MadsRudolph/esp32-surround-processor/enclosure/render/base-empty.webp

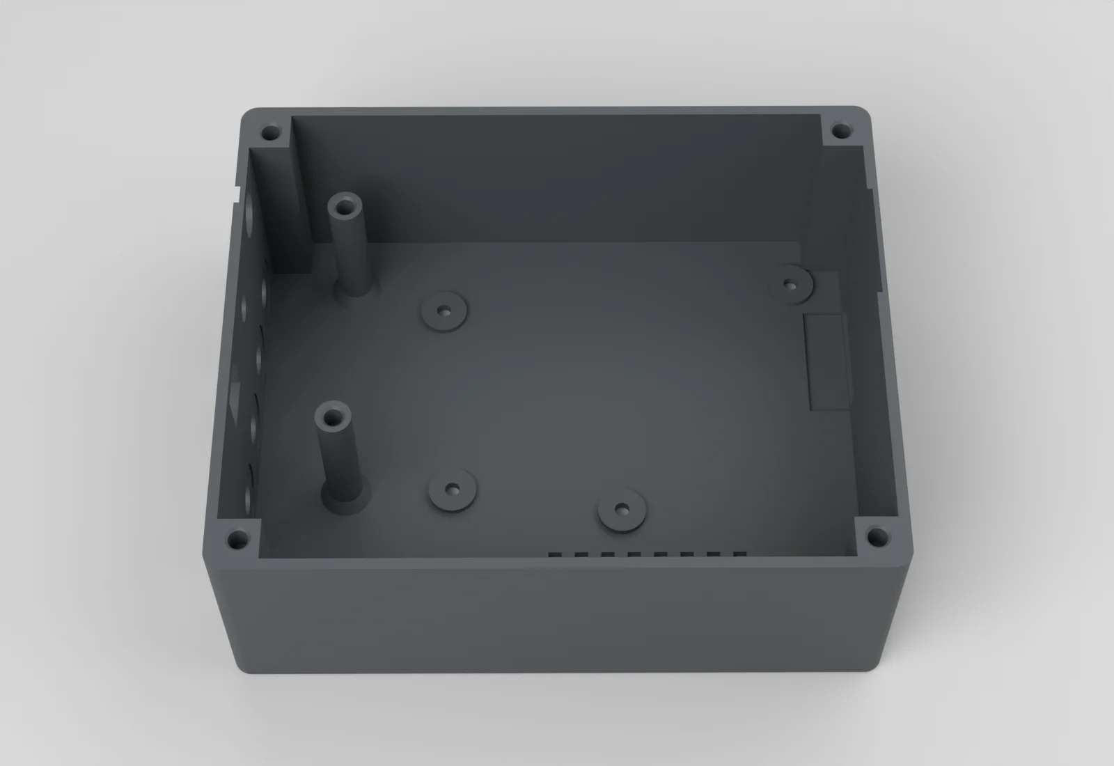
enclosure/render/base-empty.webp
