MadsRudolph/esp32-surround-processor/enclosure/render/button-cap.webp

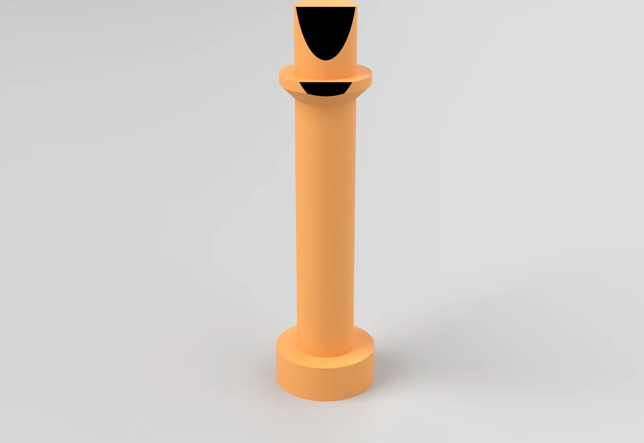
enclosure/render/button-cap.webp
