MadsRudolph/esp32-surround-processor/hardware/renders/bottom.webp

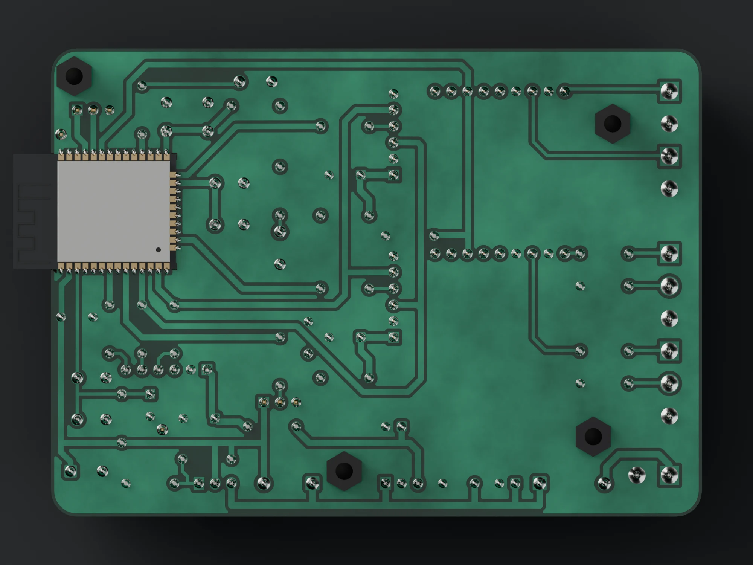
hardware/renders/bottom.webp
