MadsRudolph/esp32-surround-processor/hardware/renders/top.webp

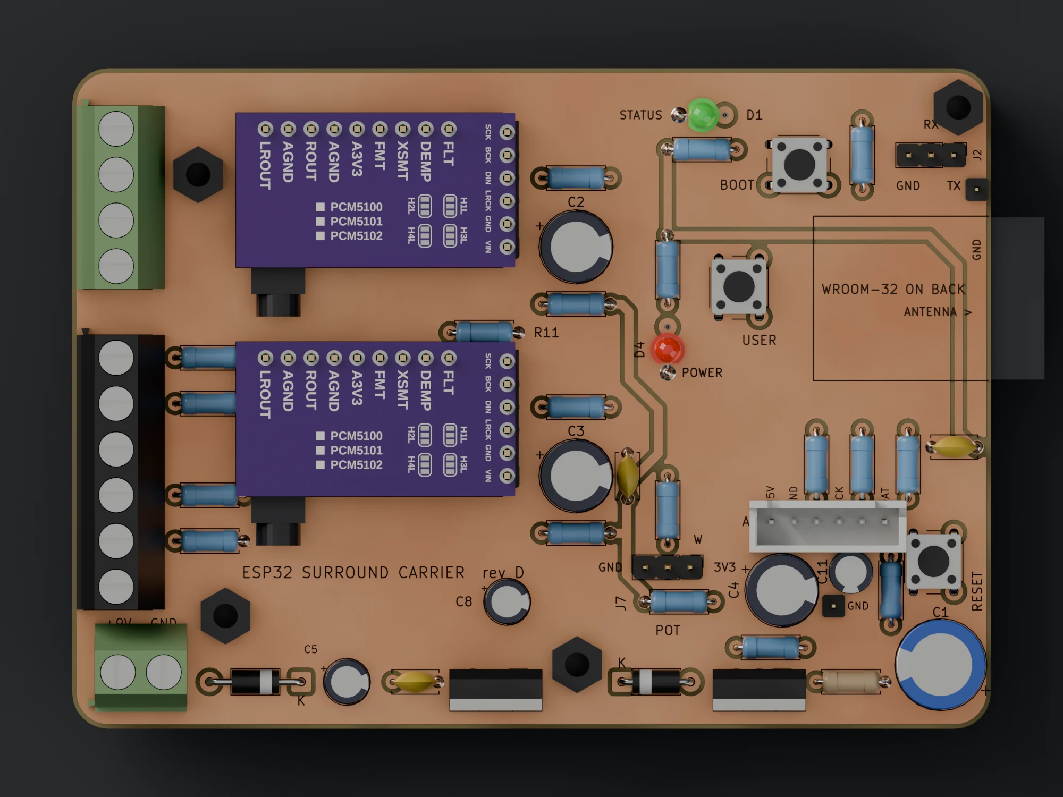
hardware/renders/top.webp
