MadsRudolph/esp32-surround-processor/enclosure/cad/Lid_Plate.step

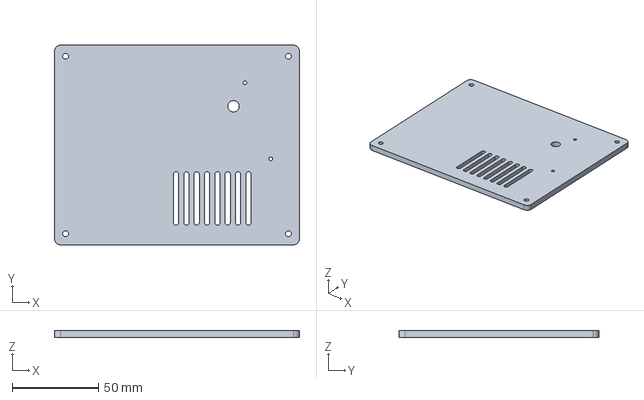
[picture p20: CAD file, 2026-11-13]
enclosure/cad/Lid_Plate.step
142.1 x 115.8 x 4.00 mm
