MadsRudolph/esp32-surround-processor/enclosure/lasercut/Lid_Plate_4mm_acrylic_R2000.dxf

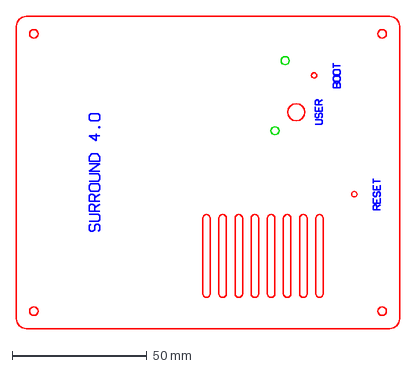
[picture p21: CAD file, 2026-11-14]
enclosure/lasercut/Lid_Plate_4mm_acrylic_R2000.dxf
142.3 x 116.0 mm
