MadsRudolph/esp32-surround-processor/enclosure/print/Pot_Fit_Test.stl

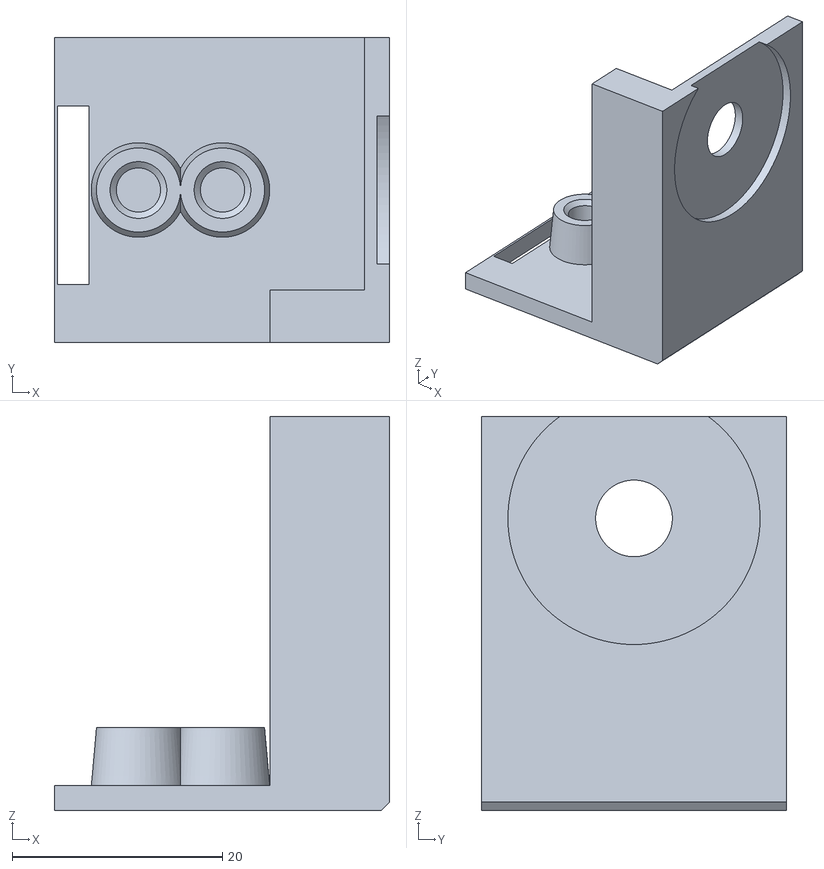
[picture p22: CAD file, 2026-11-13]
enclosure/print/Pot_Fit_Test.stl
31.9 x 29.0 x 37.5
