MadsRudolph/esp32-surround-processor/hardware/coupon/production/wroom_coupon_silk_top.dxf

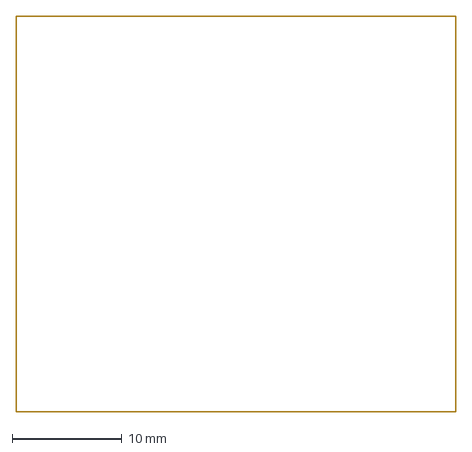
[picture p23: CAD file, 2026-11-04]
hardware/coupon/production/wroom_coupon_silk_top.dxf
40.0 x 36.0 mm
