MadsRudolph/esp32-surround-processor/hardware/production/surround_mask_bottom_mirrored.dxf

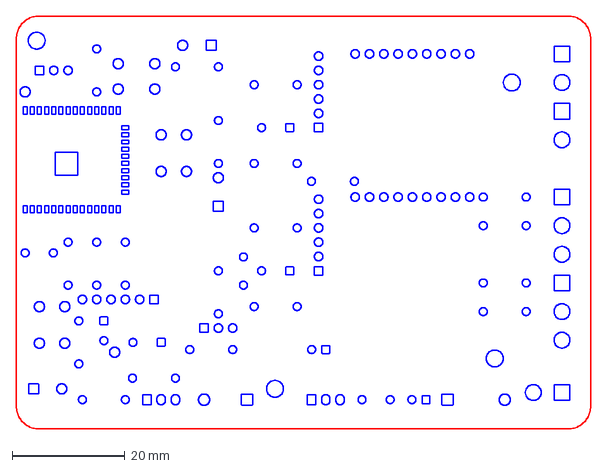
[picture p24: CAD file, 2026-11-12]
hardware/production/surround_mask_bottom_mirrored.dxf
101.9 x 73.2 mm
