MadsRudolph/esp32-surround-processor/hardware/renders/models/pcm5102_parts.step

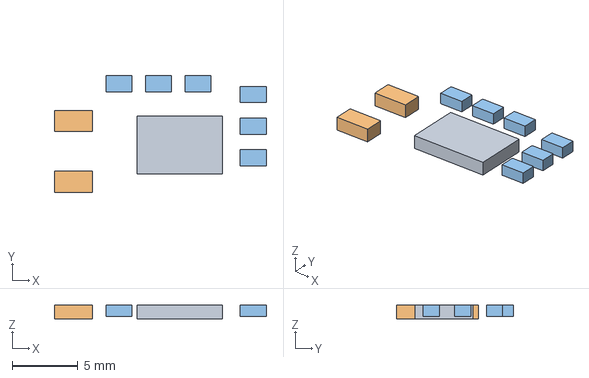
[picture p25: CAD file, 2026-11-12]
hardware/renders/models/pcm5102_parts.step
16.1 x 8.85 x 1.10 mm
