MadsRudolph/esp32-surround-processor/hardware/stencil_test/stencil_test.dxf

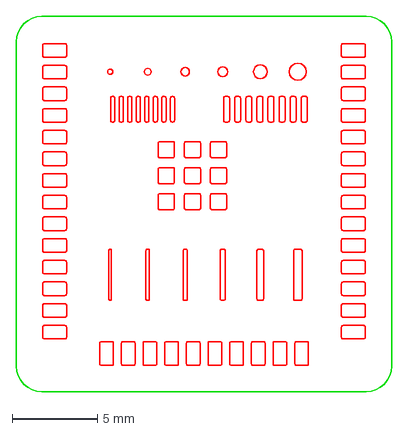
[picture p26: CAD file, 2026-11-13]
hardware/stencil_test/stencil_test.dxf
22.0 x 22.0 mm
