MadsRudolph/esp32-surround-processor/enclosure/cad/Knob.step

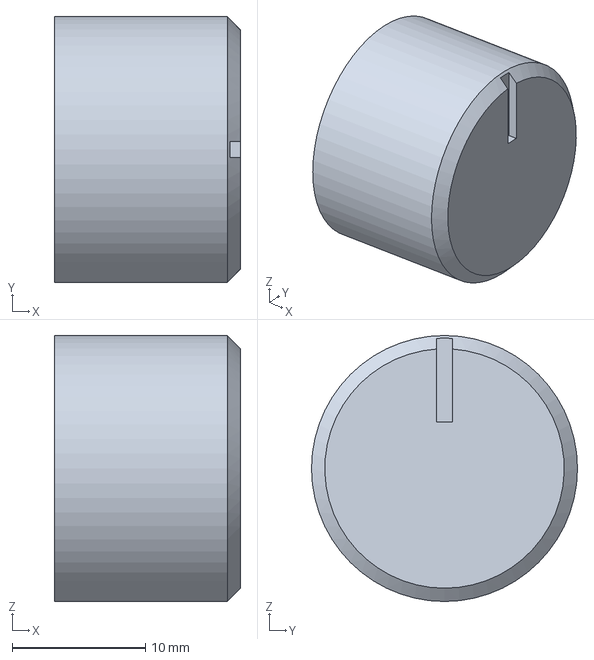
[picture p27: CAD file, 2026-11-13]
enclosure/cad/Knob.step
14.0 x 20.0 x 20.0 mm
