MadsRudolph/esp32-surround-processor/enclosure/lasercut/Lid_Plate_4mm_acrylic.dxf

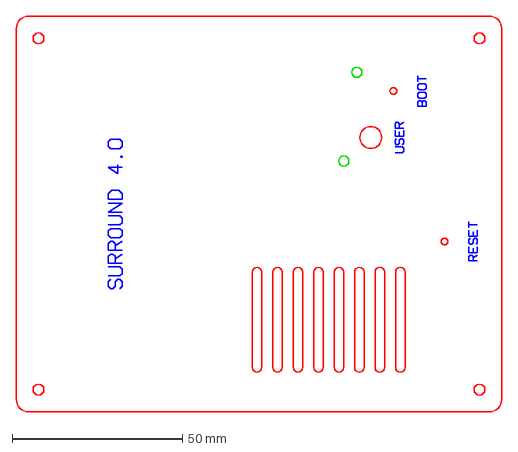
[picture p28: CAD file, 2026-11-14]
enclosure/lasercut/Lid_Plate_4mm_acrylic.dxf
142.3 x 116.0 mm
