MadsRudolph/esp32-surround-processor/hardware/renders/models/pcm5102_pins.step

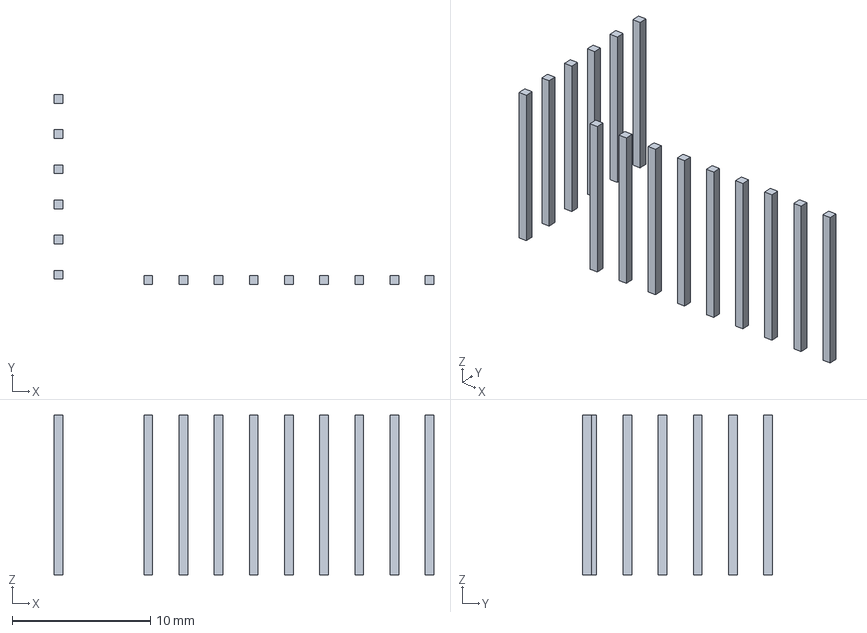
[picture p30: CAD file, 2026-11-12]
hardware/renders/models/pcm5102_pins.step
27.5 x 13.7 x 11.5 mm
