MadsRudolph/esp32-surround-processor/enclosure/cad/Pot_Cradle.step

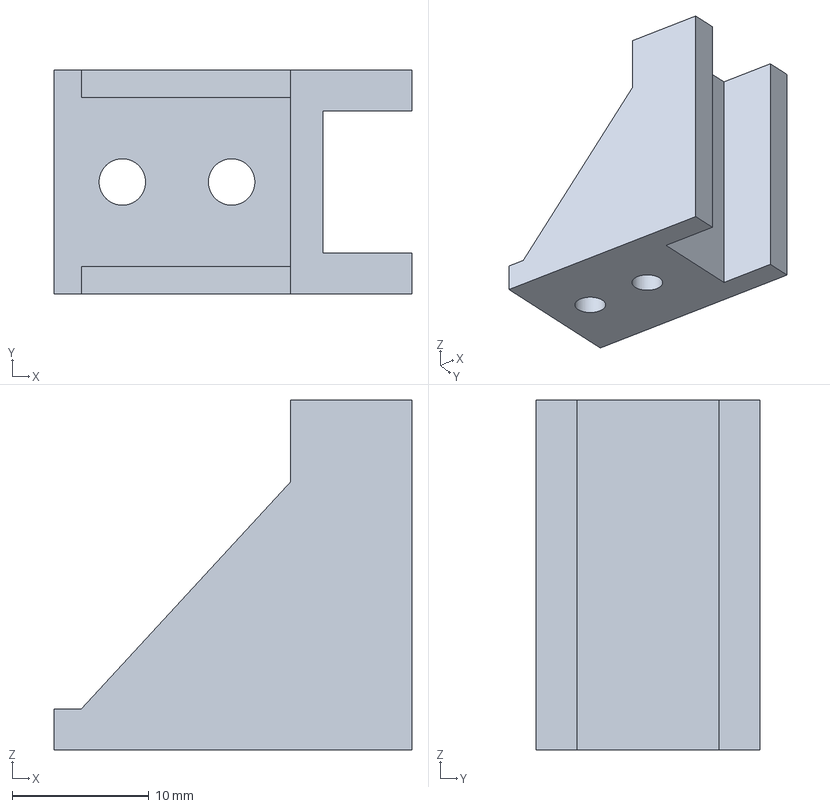
[picture p31: CAD file, 2026-11-13]
enclosure/cad/Pot_Cradle.step
26.2 x 16.4 x 25.6 mm
