MadsRudolph/esp32-surround-processor/hardware/production/surround_silk_top.dxf

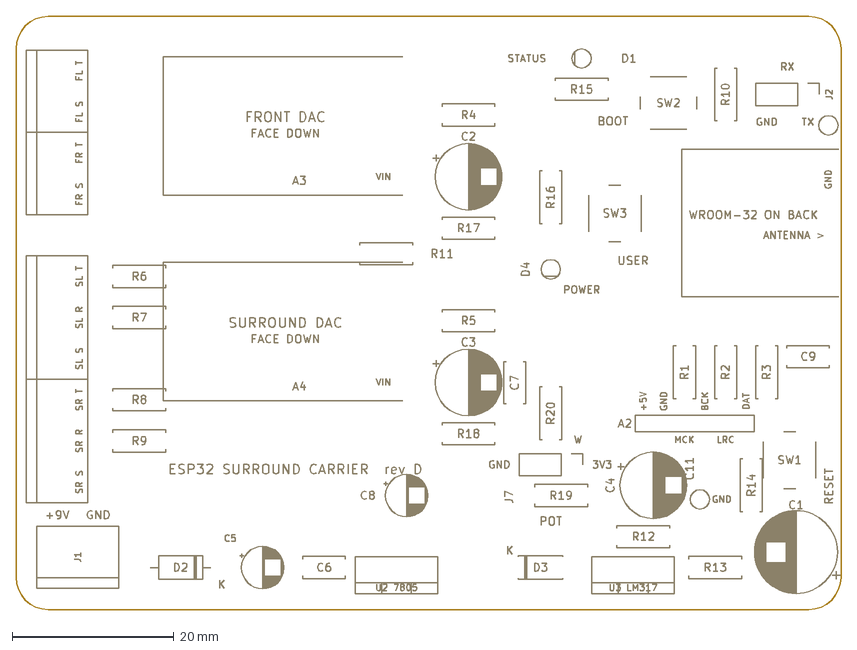
[picture p32: CAD file, 2026-11-10]
hardware/production/surround_silk_top.dxf
101.9 x 73.2 mm
