MadsRudolph/esp32-surround-processor/hardware/renders/models/pcm5102_pcb.step

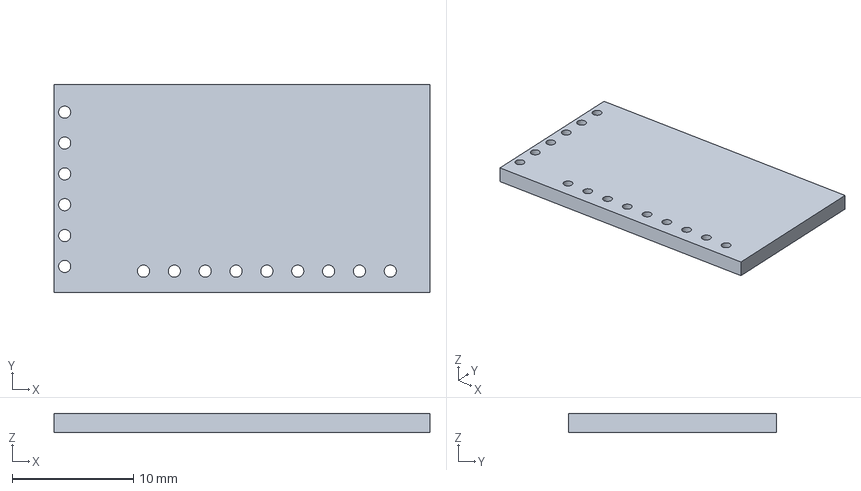
[picture p33: CAD file, 2026-11-12]
hardware/renders/models/pcm5102_pcb.step
31.0 x 17.1 x 1.60 mm
