MadsRudolph/esp32-surround-processor/enclosure/cad/User_Button.step

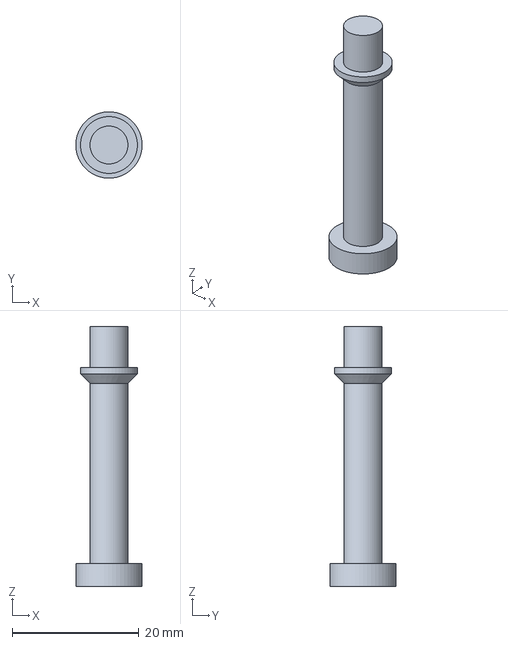
[picture p34: CAD file, 2026-11-13]
enclosure/cad/User_Button.step
10.5 x 10.5 x 41.1 mm
