MadsRudolph/esp32-surround-processor/hardware/renders/models/pcm5102_jack.step

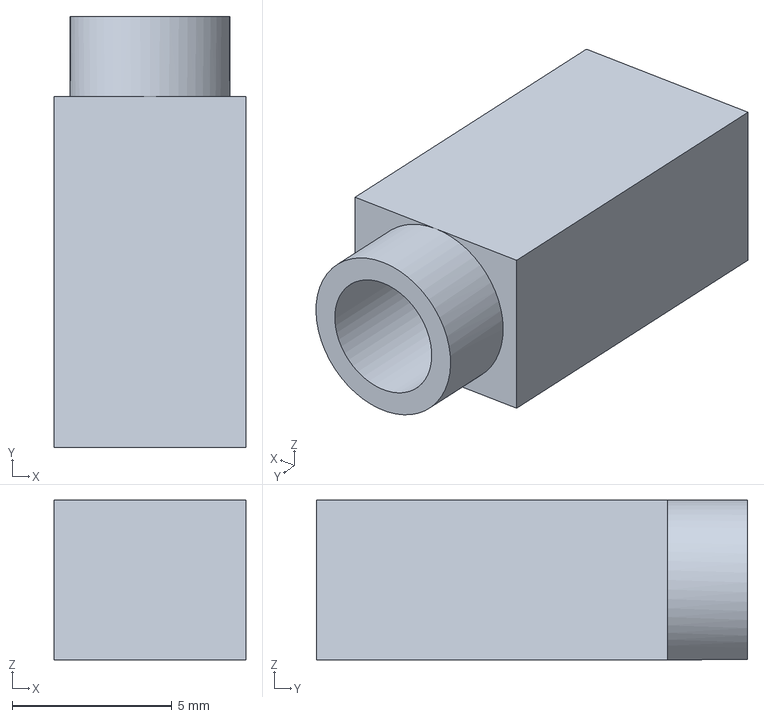
[picture p35: CAD file, 2026-11-12]
hardware/renders/models/pcm5102_jack.step
6.00 x 13.5 x 5.00 mm
