MadsRudolph/esp32-surround-processor/enclosure/cad/Base.step

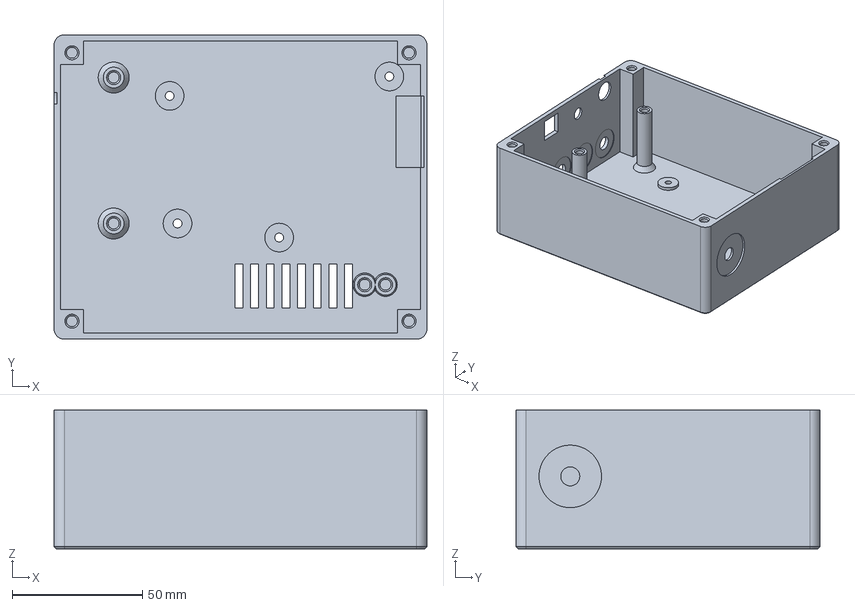
[picture p36: CAD file, 2026-11-13]
enclosure/cad/Base.step
143.1 x 116.8 x 53.2 mm
