MadsRudolph/esp32-surround-processor/hardware/renders/models/pcm5102_plastic.step

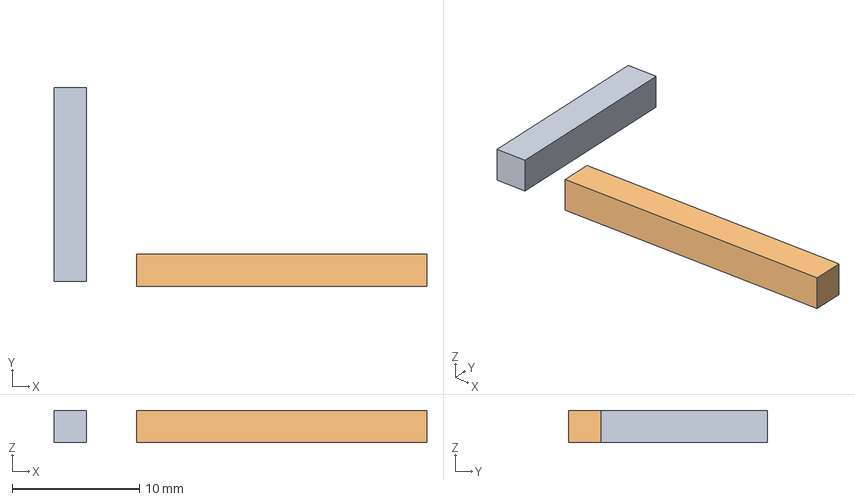
[picture p37: CAD file, 2026-11-12]
hardware/renders/models/pcm5102_plastic.step
29.4 x 15.6 x 2.54 mm
