MadsRudolph/esp32-surround-processor/enclosure/cad/surround_enclosure.step

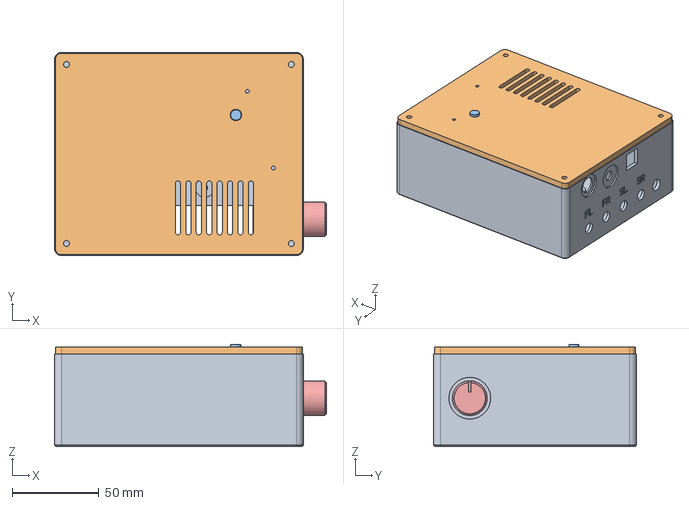
[picture p38: CAD file, 2026-11-13]
enclosure/cad/surround_enclosure.step
156.4 x 116.8 x 58.7 mm
