MadsRudolph/esp32-surround-processor/enclosure/cad/board.step

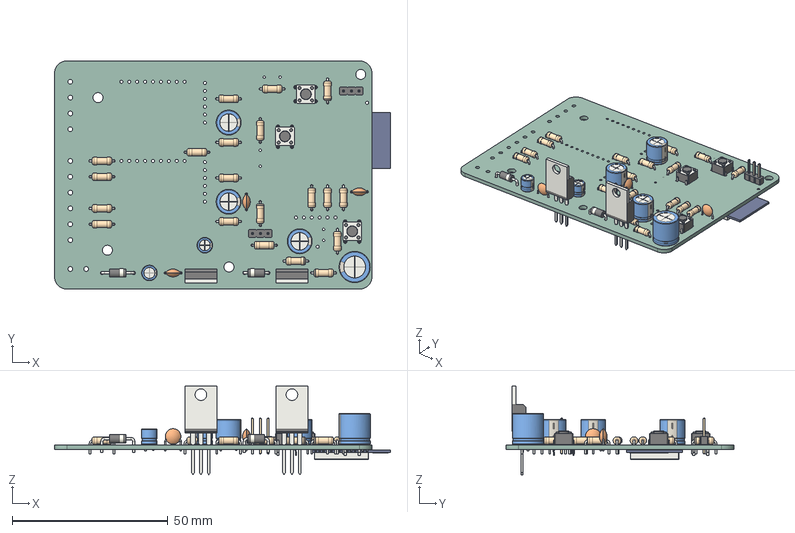
[picture p39: CAD file, 2026-11-12]
enclosure/cad/board.step
107.8 x 73.2 x 28.5 mm
PinHeader_1x03_P254mm_Vertical x 2
CP_Radial_D100mm_P500mm
CP_Radial_D80mm_P500mm x 3
R_Axial_DIN0207_L63mm_D25mm_P762mm_Horizontal x 20
TO-220-3_Vertical x 2
SW_PUSH_6mm x 3
CP_Radial_D50mm_P250mm x 2
D_DO-41_SOD81_P10.16mm_Horizontal
D_DO-41_SOD81_P7.62mm_Horizontal
C_Disc_D50mm_W25mm_P500mm x 3
ESP32-WROOM-32
surround_PCB
