MadsRudolph/esp32-surround-processor/(list of files, cad)

Other CAD files:
enclosure/cad/surround_enclosure.FCStd
enclosure/print/Base.stl
enclosure/print/Knob.stl
enclosure/print/Pot_Cradle.stl
enclosure/print/User_Button.stl
