MadsRudolph/esp32-surround-processor/tools/measure_guide.html

# Caliper measuring guide

Everything the enclosure still needs from you, with a drawing for each number. Type each answer into its box. Answers are saved in this browser as you type. Drawings are not to scale. Yellow badges on a drawing match the number on the card below it.

On a phone, swipe a drawing sideways to see all of it.

0 of 9 needed values filled inCopy answers

## 0How to measure

Outside jaws for diameters and thicknesses. Close them gently on the part, then read.

Depth rod for heights above the board: rod on the board, caliper body resting on the part top. Also for depth behind a panel.

Measure in mm. One decimal is enough. Pull the jaws away before you read if the display is hard to see, or lock it with the screw.

## AThe carrier board

Side view. Every arrow starts on the board top face (the face the parts stand on) and ends on the top of the part, except 1 and 7.

1

### Standoff length under the board

needed before printing

Pick one of the four black standoffs. Measure its length from the underside of the board to its bottom end, with the outside jaws. Look into the bottom end for a thread. Badge 1 on drawing A.

lengthmm

threaded M3 at the bottom

2

### Tallest part above the board

needed before printing

Rest the end of the depth rod on the board top, then slide the caliper body down until it touches the top of the tallest part. Read the value, and name the part. Badge 2 on drawing A.

height above top facemmwhich part

3

### Top of the DAC modules

needed before printing

Depth rod on the board top, caliper body resting on the highest point of a plugged-in DAC module (pins and solder included). Badge 3 on drawing A.

height above top facemm

4

### Top of the USER button

has a safe assumed value

Same method, on the top of the USER button plunger, not pressed. Badge 4 on drawing A.

height above top facemm

5

### Tops of the two LEDs

has a safe assumed value

Same method on the top of each LED dome. If the two differ, type the taller one. Badge 5 on drawing A.

height above top facemm

I will straighten them

6

### Screw terminal and blue capacitor

has a safe assumed value

Same method twice: once on the top of a screw terminal block, once on the top of the blue 470 uF can. Badges 6a and 6b on drawing A.

screw terminal heightmmblue capacitor heightmm

7

### Board thickness

has a safe assumed value

Close the outside jaws on the bare edge of the board, away from solder blobs. Badge 7 on drawing A.

thicknessmm

## BThe DIR9001 module

The green receiver board stacked above the carrier. Values 9, 10 and 14 are already settled.

8

### Standoff under the DIR9001 module

needed before printing

Measure straight up from the carrier top face to the underside of the module board (the standoff length is the same number). Solder joints under the module do not count. Badge 8 on drawing B.

gapmm

15

### Tallest part on the module

needed before printing

Depth rod on the module top face, caliper body on the highest part (look at the can, the optical socket and the toggle). Measure from the module top face, not from the carrier. Badge 15 on drawing B.

height above module top facemm

Top view of the socket edge, the long edge with the three sockets sticking out.

11

### Optical (TOSLINK) socket position

has a safe assumed value

11a: from the nearer short end of the module board to the middle of the socket opening (measure to the near side of the socket and add half its width). 11b: from the board edge to the front face of the socket. Badges 11a and 11b on drawing C.

11a end to centremm11b sticks outmm

12

### Toggle switch reach

has a safe assumed value

12a: from the board edge to the end of the threaded bushing. 12b: from the board edge to the lever tip, lever straight out. Badges 12a and 12b on drawing C.

12a bushingmm12b lever tipmm

13

### Coax RCA barrel

has a safe assumed value

From the board edge to the end of the metal barrel. Badge 13 on drawing C.

barrel sticks outmm

16

### Pigtail length

has a safe assumed value

Lay the cable straight and measure from the end of one plug to the end of the other. A ruler is fine. The layout needs 100 or more. Badge 16 on the small drawing.

plug to plugmm

## CPanel parts

The same three measurements for each jack. Part numbers are fine if a jack is not at hand. Swipe the drawing sideways if it is cut off on a phone.

A thread diameter, the hole the panel needs. B widest diameter of the nut or flange. C depth of the body and lugs behind the panel.

17a

### Gold RCA jack

needed before printing

Outside jaws on the threaded barrel (A) and on the nut or flange at its widest, corners of a hex nut included (B). Depth rod from the face that sits against the back of the panel to the rear end of the body and lugs (C). Letters A, B, C on drawing D.

A thread diametermmB flange / nut diametermmC depth behind panelmm

17b

### TRS jack

needed before printing

Outside jaws on the threaded barrel (A) and on the nut or flange at its widest, corners of a hex nut included (B). Depth rod from the face that sits against the back of the panel to the rear end of the body and lugs (C). Letters A, B, C on drawing D.

A thread diametermmB flange / nut diametermmC depth behind panelmm

plug size6.35 mm3.5 mm

17c

### DC jack

needed before printing

Outside jaws on the threaded barrel (A) and on the nut or flange at its widest, corners of a hex nut included (B). Depth rod from the face that sits against the back of the panel to the rear end of the body and lugs (C). Letters A, B, C on drawing D.

A thread diametermmB flange / nut diametermmC depth behind panelmm

The potentiometer, with its knob.

18

### Potentiometer

needed before printing

A thread (outside jaws on the bushing), B body diameter, C depth from the panel side of the body to its rear face (not the pins), D shaft diameter, E shaft length from the bushing end to the tip, F knob diameter (outside jaws across the knob). Letters A to F on drawing E.

A thread diametermmB body diametermmC body depthmmD shaft diametermmE shaft lengthmmF knob diametermm

## DTwo questions

19

### LM317 heatsink

no measuring

Will the LM317 regulator get a heatsink? If yes, give the size of the heatsink you plan to use.

heatsinkyesno

widthmmdepthmmtop above boardmm

?

### Jacks in hand

no measuring

Do you have the TRS jacks and the DC jack yet?

have themyesno

note (part numbers, where from)

## ✓Copy answers

One line per answered item. Unanswered items are left out. If the button cannot reach the clipboard, select the text below by hand.

Copy answersClear all
