MadsRudolph/esp32-surround-processor/hardware/stencil_test/preview.png

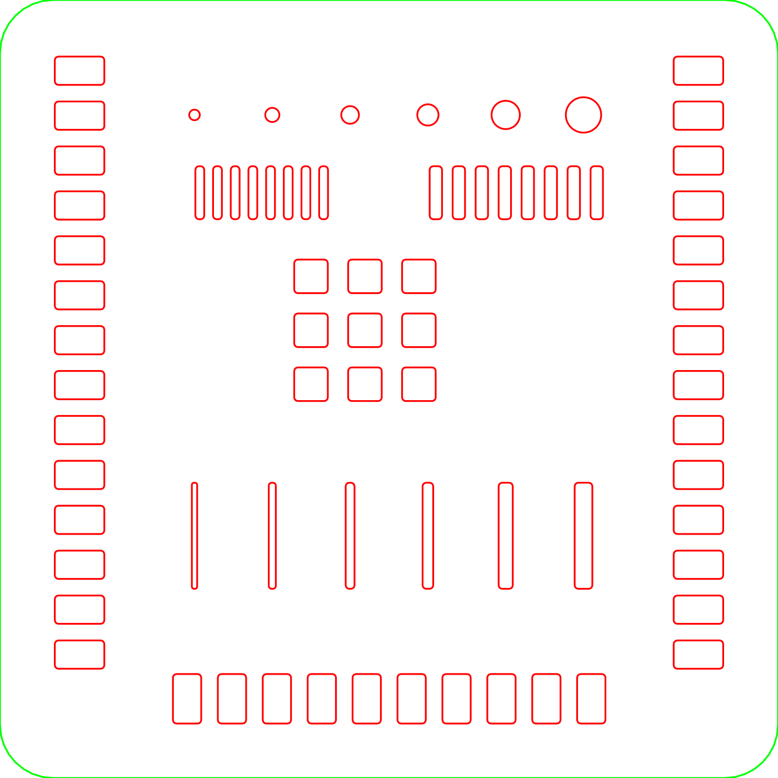
hardware/stencil_test/preview.png
