MadsRudolph/esp32-surround-processor/tools/debug_page.html

# Board debug

connecting Speaker wiring guide ← back to the bench

## Digital input

--Hz

waiting

## Volume pot (J7)

--dB

raw -- of 4095 · gain ×--

## Output

Mode: --

USER toggles mute. BOOT steps the mode: surround, stereo on all four, front only.

## Speaker test a test sound on one output only, the input is ignored

Front left Front right Surround left Surround right All four Stop test

Sound: Chime Sine sweep, 100 Hz to 10 kHz

The test follows the volume pot and is silent while the board is muted.

Board: Mute / unmute Mode: Surround Stereo on all four Front only

Data line drive (click hunting): Weakest Weak Normal Strong

## Input level, peak per second (before the volume pot)

L

R

S

dBFS

S (green) is what goes to the rear speakers. On stereo sound it is the matrix signal, 0.5 × (L − R) after its filters and delay. On Dolby Digital it is the louder of the two real rear channels, and L and R are the decoded fronts. Last two minutes. White marks on the bars hold the highest peak of the last 10 s. 0 dBFS is digital full scale.

## Audio path health

Read timeouts (no clock from the DIR9001) | --
Write errors (DAC side) | --
Since this page opened | --
Dolby Digital frames decoded | --
Dolby errors / dropped / underruns | --
Dolby decode time, average / worst (32 ms budget) | --

## Board

Firmware | --
Built | --
Running from | --
Uptime | --
Free memory | --
Address | --

Bench setup: the AD3 in place of the TV

Not yet proven on this board: that the DIR9001 locks to the AD3's signal. The generator itself passes its self-test.

### Move and power

1. Put the board on the bench and power it from the bench supply: 9 V, current limit 0.5 A. On the DIR9001 module (the green board stacked on top, marked "LHY AUDIO DIR9001-I2S"), flip the toggle switch to the coax input.

### Make the cable

2. Take a spare RCA cable and cut one end off. Inside are a centre conductor and a shield. The RCA plug at the other end goes into the red RCA jack on the DIR9001 module.

### Three resistors, wired at the cut end

3. All three are from home stock. Wire them like this:
  This turns the AD3's 3.3 V into about 0.4 to 0.8 V, the normal level for coax S/PDIF.

### Other AD3 connections

  - DIO 0 stays on the board's serial pin J2 TX. This is optional, it is for the console.
  - Scope probes set to 10x. Probe 1 on BCK at the front DAC socket. Probe 2 on that DAC's data pin. Ground clips on the DAC's ground.

The probe positions change from test to test. These are the ones for the first test.

### Start the generator

5. Run these from the repo folder:

python3 tools/spdif_gen.py selftest
python3 tools/spdif_gen.py run 1017 1526 -12
  selftest needs no wiring. It checks the AD3 pattern by reading it back. run 1017 1526 -12 plays 1017 Hz on the left, 1526 Hz on the right, at -12 dBFS. Ctrl-C stops it.
  A negative right frequency, for example run 1017 -1017 -12, sends the same tone inverted on the right. That is pure surround for the matrix decoder.
  Only one program can use the AD3 at a time. Before starting the generator, press "Release AD3" on the bench page (http://127.0.0.1:8791/). Do not run scope measurements there while the generator runs.

### What you should see on this page

  - Digital input: "LOCKED, 48 kHz PCM" with about 48,828 Hz. The AD3's rate is 1.7 % above 48,000, which is fine.
  - The L and R meters at about -12 dB.
  - With the two different tones, the S meter is active.

If it stays on "NO INPUT SIGNAL", check that the toggle is on coax, that the centre and shield are not swapped, and that the generator is running.

### What this setup can and cannot test

7. Can:
  - Clicks and data-line disturbance, with the scope.
  - Long soak tests.
  - Distortion and noise of each output.
  - The stereo matrix decoder.

Cannot:

  - Dolby Digital. One Dolby frame needs 1,536 audio frames and the AD3 pattern memory holds 256. That stays tested with the TV and with tools/dolby_test.sh on the PC.
