MadsRudolph/esp32-surround-processor/hardware/surround.kicad_pcb

## KiCad design hardware/surround.kicad_pcb (2026-11-10)

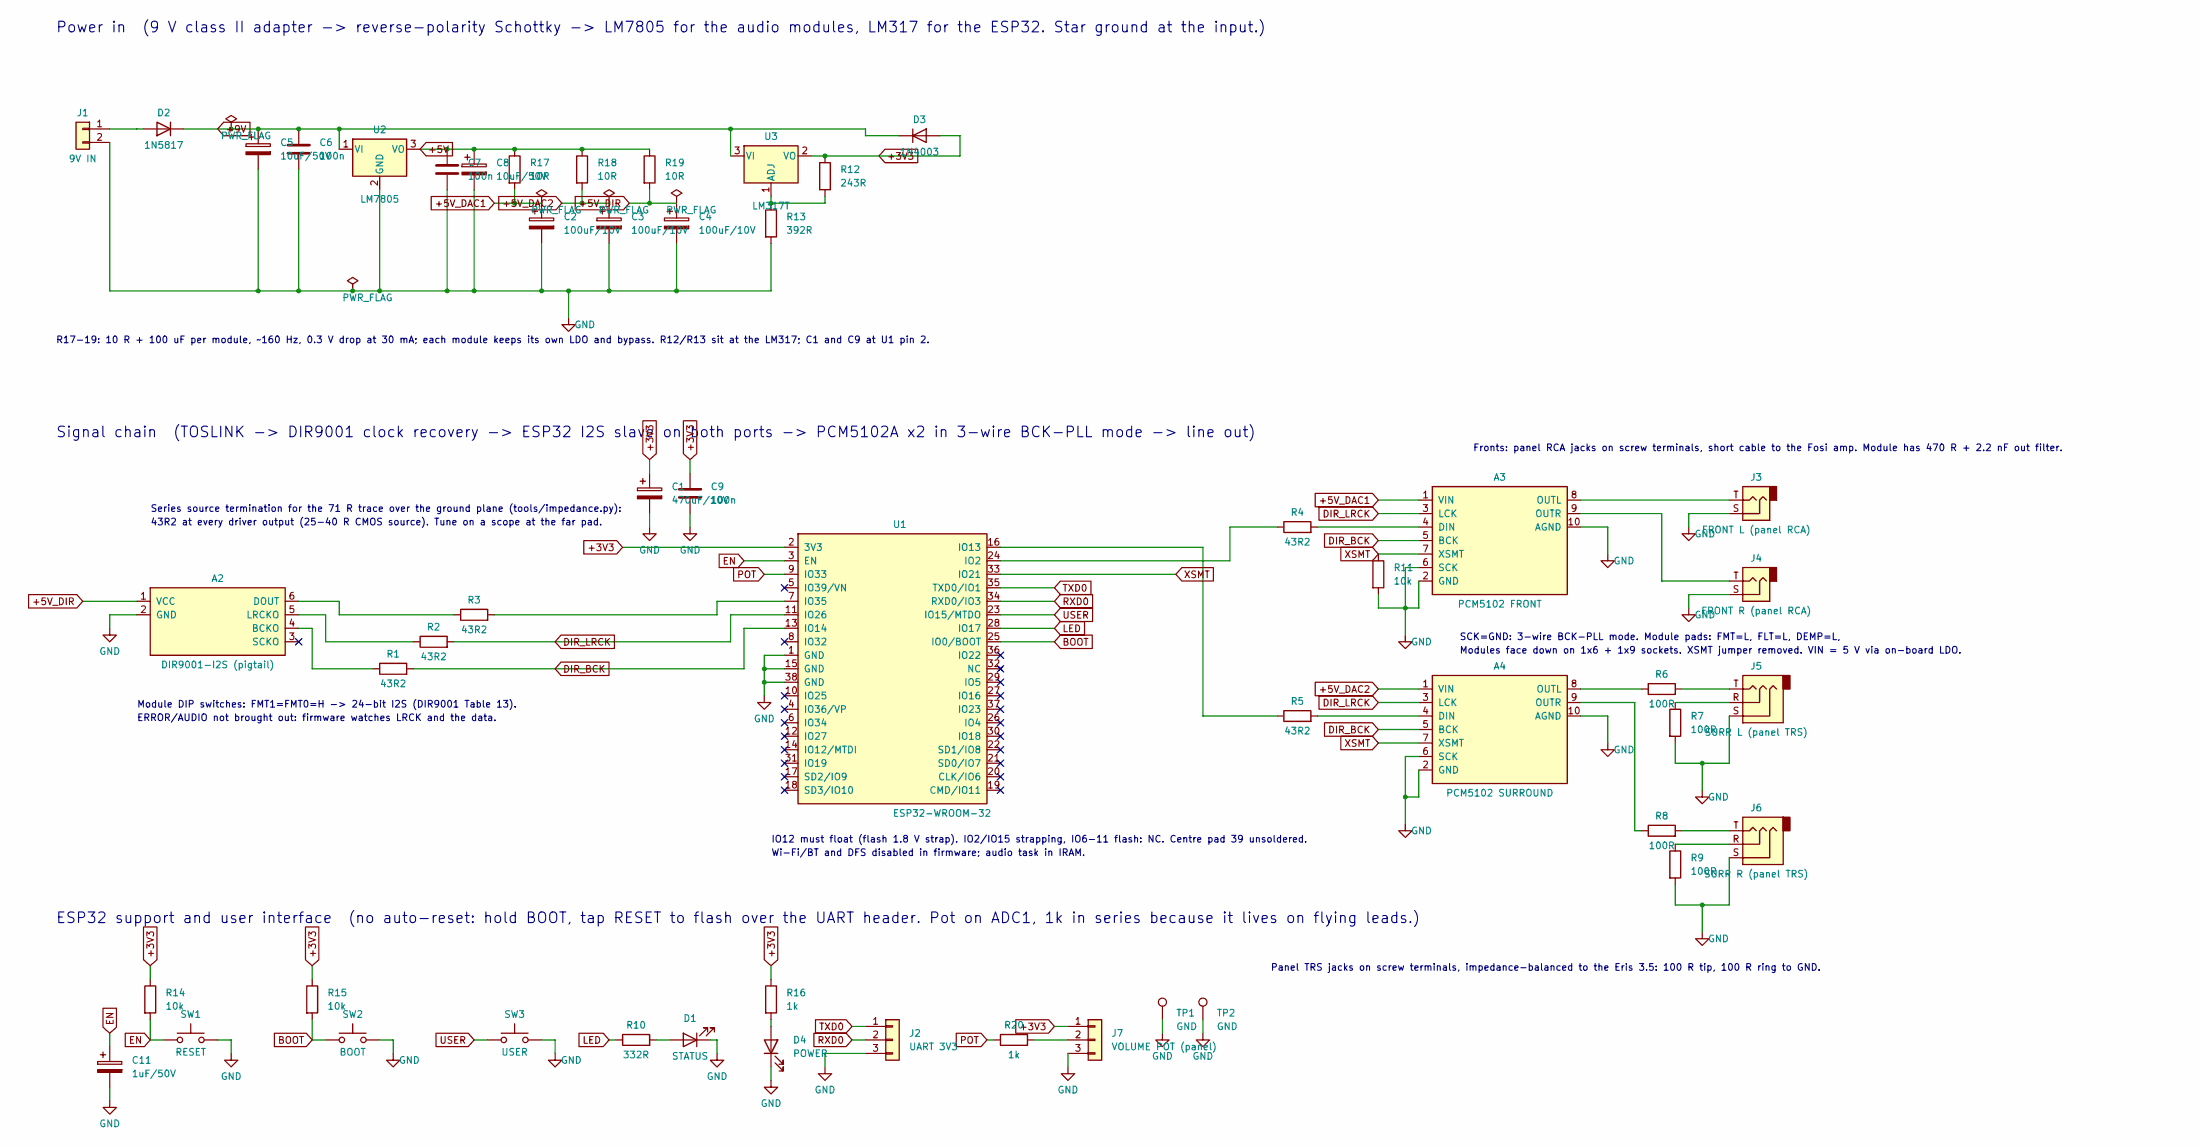
[picture p42: schematic surround.kicad_sch, ESP32 4.0 surround processor - carrier board]

Parts:
A2: DIR9001-I2S (pigtail); DIR9001_Pigtail_1x6
A3: PCM5102 FRONT; PCM5102_Module_FaceDown
A4: PCM5102 SURROUND; PCM5102_Module_FaceDown
C1: 470uF/10V; CP_Radial_D10.0mm_P5.00mm
C2, C3, C4: 100uF/10V; CP_Radial_D8.0mm_P5.00mm
C5, C8: 10uF/50V; CP_Radial_D5.0mm_P2.50mm
C6, C7, C9: 100n; C_Disc_D5.0mm_W2.5mm_P5.00mm
C11: 1uF/50V; CP_Radial_D5.0mm_P3.50mm_FormedLeads
D1: STATUS; LED_D3.0mm_P5.08mm_LaserPads
D2: 1N5817; D_DO-41_SOD81_P10.16mm_Horizontal
D3: 1N4003; D_DO-41_SOD81_P7.62mm_Horizontal
D4: POWER; LED_D3.0mm_P5.08mm_LaserPads
J1: 9V IN; TerminalBlock_2P_P5.08mm
J2: UART 3V3; PinHeader_1x03_P2.54mm_Vertical
J3: FRONT L (panel RCA); TerminalBlock_TS_P5.08mm
J4: FRONT R (panel RCA); TerminalBlock_TS_P5.08mm
J5: SURR L (panel TRS); TerminalBlock_TRS_P5.08mm
J6: SURR R (panel TRS); TerminalBlock_TRS_P5.08mm
J7: VOLUME POT (panel); PinHeader_1x03_P2.54mm_Vertical
R1, R2, R3, R4, R5: 43R2; R_Axial_DIN0207_L6.3mm_D2.5mm_P7.62mm_Horizontal
R6, R7, R8, R9: 100R; R_Axial_DIN0207_L6.3mm_D2.5mm_P7.62mm_Horizontal
R10: 332R; R_Axial_DIN0207_L6.3mm_D2.5mm_P7.62mm_Horizontal
R11, R14, R15: 10k; R_Axial_DIN0207_L6.3mm_D2.5mm_P7.62mm_Horizontal
R12: 243R; R_Axial_DIN0207_L6.3mm_D2.5mm_P7.62mm_Horizontal
R13: 392R; R_Axial_DIN0207_L6.3mm_D2.5mm_P7.62mm_Horizontal
R16, R20: 1k; R_Axial_DIN0207_L6.3mm_D2.5mm_P7.62mm_Horizontal
R17, R18, R19: 10R; R_Axial_DIN0207_L6.3mm_D2.5mm_P7.62mm_Horizontal
SW1: RESET; SW_PUSH_6mm
SW2: BOOT; SW_PUSH_6mm
SW3: USER; SW_PUSH_6mm
TP1, TP2: GND; TestPoint_THTPad_D2.0mm_Drill1.0mm
U1: ESP32-WROOM-32; ESP32-WROOM-32_NoVias
U2: LM7805; TO-220-3_Vertical_LaserPads
U3: LM317T; TO-220-3_Vertical_LaserPads

Connections:
+3V3: C1.1, C9.1, D3.2 (A), J7.1, R12.1, R14.1, R15.1, R16.1, U1.2 (3V3), U3.2 (VO)
+5V: C7.1, C8.1, R17.1, R18.1, R19.1, U2.3 (VO)
BOOT: R15.2, SW2.1, U1.25 (IO0/BOOT)
DIR_BCK: A3.5 (BCK), A4.5 (BCK), R1.2, U1.13 (IO14)
DIR_LRCK: A3.3 (LCK), A4.3 (LCK), R2.2, U1.11 (IO26)
EN: C11.1, R14.2, SW1.1, U1.3 (EN)
LED: R10.1, U1.28 (IO17)
unnamed: A2.4 (BCKO), R1.1
unnamed: A2.6 (DOUT), R3.1
unnamed: A2.5 (LRCKO), R2.1
unnamed: A3.4 (DIN), R4.2
unnamed: A3.8 (OUTL), J3.T
unnamed: A3.9 (OUTR), J4.T
unnamed: A4.4 (DIN), R5.2
unnamed: A4.8 (OUTL), R6.1
unnamed: A4.9 (OUTR), R8.1
unnamed: D1.2 (A), R10.2
unnamed: D2.2 (A), J1.1
unnamed: D4.2 (A), R16.2
unnamed: J5.R, R7.1
unnamed: J5.T, R6.2
unnamed: J6.R, R9.1
unnamed: J6.T, R8.2
unnamed: J7.2, R20.2
unnamed: R4.1, U1.24 (IO2)
unnamed: R5.1, U1.16 (IO13)
unnamed: R3.2, U1.7 (IO35)
unnamed: R12.2, R13.1, U3.1 (ADJ)
POT: R20.1, U1.9 (IO33)
RXD0: J2.2, U1.34 (RXD0/IO3)
TXD0: J2.1, U1.35 (TXD0/IO1)
USER: SW3.1, U1.23 (IO15/MTDO)
XSMT: A3.7 (XSMT), A4.7 (XSMT), R11.1, U1.33 (IO21)

Notes on the sheet:
Power in (9 V class II adapter -> reverse-polarity Schottky -> LM7805 for the audio modules, LM317 for the ESP32. Star ground at the input.)
R17-19: 10 R + 100 uF per module, ~160 Hz, 0.3 V drop at 30 mA; each module keeps its own LDO and bypass. R12/R13 sit at the LM317; C1 and C9 at U1 pin 2.
Signal chain (TOSLINK -> DIR9001 clock recovery -> ESP32 I2S slave on both ports -> PCM5102A x2 in 3-wire BCK-PLL mode -> line out)
Series source termination for the 71 R trace over the ground plane (tools/impedance.py):
43R2 at every driver output (25-40 R CMOS source). Tune on a scope at the far pad.
Module DIP switches: FMT1=FMT0=H -> 24-bit I2S (DIR9001 Table 13).
ERROR/AUDIO not brought out: firmware watches LRCK and the data.
IO12 must float (flash 1.8 V strap). IO2/IO15 strapping, IO6-11 flash: NC. Centre pad 39 unsoldered.
Wi-Fi/BT and DFS disabled in firmware; audio task in IRAM.
SCK=GND: 3-wire BCK-PLL mode. Module pads: FMT=L, FLT=L, DEMP=L,
Modules face down on 1x6 + 1x9 sockets. XSMT jumper removed. VIN = 5 V via on-board LDO.
Fronts: panel RCA jacks on screw terminals, short cable to the Fosi amp. Module has 470 R + 2.2 nF out filter.
Panel TRS jacks on screw terminals, impedance-balanced to the Eris 3.5: 100 R tip, 100 R ring to GND.
ESP32 support and user interface (no auto-reset: hold BOOT, tap RESET to flash over the UART header. Pot on ADC1, 1k in series because it lives on flying leads.)

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
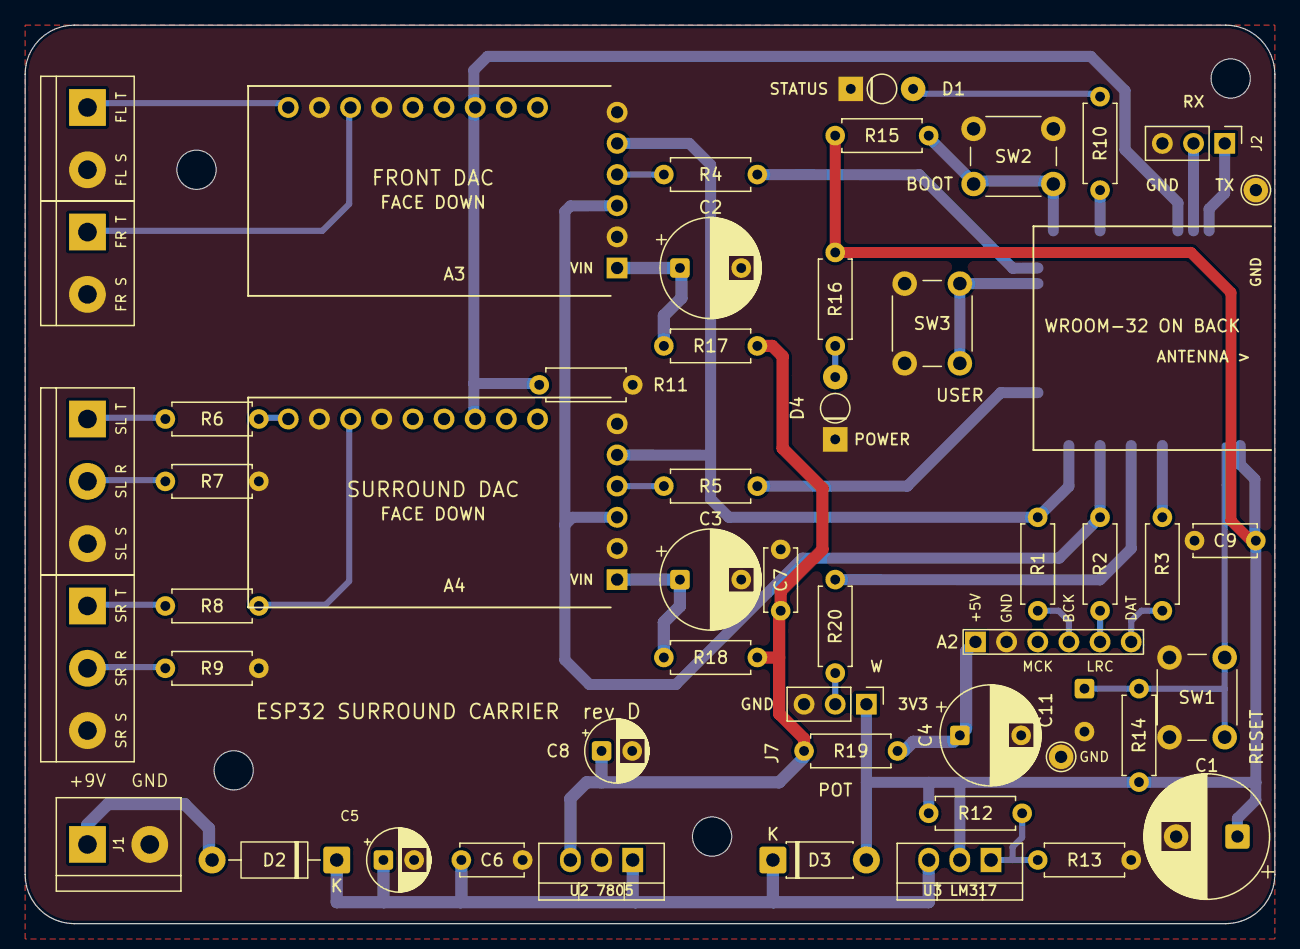
[picture p43: board surround.kicad_pcb from above]

Board: 2 copper layers, 101.9 x 73.2 mm, 56 parts (1 on the bottom side), 38 nets.

Other parts of the board:
H1, H2, H3, H4: M3; MountingHole_3.2mm_M3
