MadsRudolph/esp32-surround-processor/(commit log)

2026-09-10 Initial design: review document and KiCad carrier-board schematic
    Engineering review of the ESP32 4.0 surround processor (clocking, pinout,
    wiring, power, grounding, firmware and buffer sizing), and a KiCad 10
    project for the carrier board that hosts the ESP32-DevKitC, DIR9001 and
    two GY-PCM5102 modules. The schematic is generated by
    tools/surround_layout.py from project symbols built by
    tools/make_symbols.py; ERC is clean and the exported netlist has been
    checked against the review's topology.
    [surround.kicad_sch]
2026-09-10 Footprints, board bootstrap and hand placement for the carrier PCB
    Project footprint library (module carriers on pin sockets, screw terminals
    for the panel jacks, encoder header, mill-safe LED pads), every pad gap
    audited against the 0.8 mm end mill; sockets get intra-footprint DRC
    exceptions in surround.kicad_dru. The I2S GPIO map is re-ordered so the
    DIR9001-sourced and DAC-bound signals form two contiguous groups on the
    DevKitC socket row, which the floor oracle certifies routes single-sided
    with the GND pour and no wire bridge. Board is 140 x 110 mm, placed from
    tools/surround.placement.json.
    [surround.kicad_pcb, surround.kicad_sch]
2026-09-11 Route the carrier board single-sided, with the fast nets on milled copper
    The I2S clocks and data and the DAC outputs are pinned to the bottom layer for
    the whole route, so every wire link that comes back lands on a DC rail, ground,
    or a slow control line; tools/wire_links.py fails the build otherwise. 47 of 48
    nets route, with no vias and no clearance violations.
    Track widths follow from the process rather than from a default. The 0.8 mm end
    mill limits the copper GAP, not the track, so signal tracks are 0.8 mm and power
    1.5 mm: at 0.8 mm the pitch is 1.65 mm and the corridor beside the DAC headers
    takes two tracks instead of one, which is what made the board routable.
    With the ground pou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
    [surround.kicad_pcb, surround.kicad_sch, surround.routed.kicad_pcb]
2026-11-04 Redesign the carrier board for the 0.8 mm ball mill
    The board moves to the cnc-fine rules (0.50/0.50) and is now 133 x 70 mm and
    single-sided, with no vias. The ESP32-DevKitC carrier is replaced by a bare
    WROOM-32 soldered on the milled side, the barrel jack by a 9 V screw terminal,
    and the encoder by a pot and three buttons. The DAC modules get a worst-case
    32 x 24 mm reservation until they have been measured.
    Copper is now written by tools/surround_board.py instead of FreeRouting, and the
    build stops if a rule breaks: every segment is horizontal, vertical or 45 degrees,
    no run turns by more than 45 degrees, and every track leaving the ESP32 is 0.9 mm,
    the width of its pads. Parts are plac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
    [surround.kicad_pcb, surround.kicad_sch, surround.routed.kicad_pcb, surround_silk_top.dxf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]
2026-11-09 Compact 103 x 69 mm layout with the antenna off the edge (work in progress)
    The WROOM-32 now sits at the east edge with its antenna pointing off the board,
    so the keep-out starts at the edge. Its castellation rows face north and south,
    and the GPIOs are reassigned so each signal leaves the pin facing its copper
    (pin map in hardware/BUILD-NOTES.md).
    DACs: measured PCM5102A modules mount face down on a 1x6 and a 1x9 socket, so
    XSMT and the outputs are socketed. DIR9001: the LHY AUDIO DIR9001-I2S board
    sits off the carrier; its pigtail lands on six labelled pads. ERROR and AUDIO
    are dropped; firmware watches LRCK and the data instead.
    Routing is done by tools/octoroute.py, a single-layer octi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
    [surround.kicad_pcb, surround.kicad_sch]
2026-11-09 Double-sided board: ground plane on top, no vias, no wire links
    The carrier is re-laid-out from scratch for double-sided stock, 101.9 x 71.1 mm,
    both faces milled with the 0.8 mm ball mill. The holes are bare, so the faces
    meet only at 19 leads soldered on both sides: resistors, disc caps, LEDs, the
    7805 and two wire loops that double as scope grounds.
    The bottom carries every clock, data and audio track and the WROOM-32, antenna
    off the east edge. The top is a ground plane with a ring round each non-ground
    hole, plus +5V to the DAC feed resistors and +3V3 to the BOOT pull-up and the
    power LED. The two DAC blocks are identical, 25.4 mm apart; BCK runs dead
    straight under the parts that stra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
    [surround.kicad_pcb, surround.kicad_sch, surround_silk_top.dxf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]
2026-11-10 Hand-finish the board: rounded outline, chamfered corners, mask and silk Gerbers
    The outline gets rounded corners and grows to 101.9 x 73.3 mm. Several track
    corners are re-drawn with 45 degree chamfers, the +9V rail and a few short nets
    are re-laid, and C9 is turned so its ground lead sits west of the +3V3 lead.
    The east edge is unchanged, so the antenna still hangs off it.
    The export now also writes F.Silkscreen, F.Mask and B.Mask, which SRM-CAM
    turns into the laser files for the silkscreen and the solder mask.
    DRC has no copper errors and nothing unconnected, and check_board.py still
    passes on the same 19 leads. The README says how to re-export after a hand
    change, since tools/build.sh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
    [surround-B_Cu.gbl, surround-B_Mask.gbs, surround-Edge_Cuts.gm1, surround-F_Cu.gtl, surround-F_Mask.gts, surround-F_Silkscreen.gto, surround-job.gbrjob, surround.drl]
2026-11-12 Firmware and bench tools: Dolby Digital 5.1 and stereo matrix on four speakers
    The board is cut, soldered and brought up, and it plays.
    Firmware (ESP-IDF v5.5, firmware/):
    - surround: decodes Dolby Digital (AC-3) from the TV's optical bitstream with
    liba52 and sends real rear left and right to the surround DAC; stereo PCM goes
    through a matrix (0.5 x (L - R), 100 Hz to 7 kHz, 20 ms delay). Centre and LFE
    are folded into the fronts. Volume pot, mute, modes, speaker test (chime or
    sine sweep), all readable and settable over HTTP.
    - passthrough and boardtest: the two bring-up firmwares.
    - components/netota: Wi-Fi, over-the-air update with rollback, /status, /set.
    - components/dolby: IE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
    [surround_mask_bottom_mirrored.dxf, surround_mask_top_not_mirrored.dxf]
2026-11-12 Licence: GPL-3.0-or-later, with the notices the two third-party parts need
    - LICENSE: the GNU GPL version 3 for the firmware, tools and hardware files.
    - liba52: a dated change notice at the top of imdct.c, as its GPL asks.
    - ESP-IDF's I2S driver: the Apache 2.0 licence text beside it and a change
    notice in i2s_common.c.
    - README: who owns what, why the whole is GPL 3, and the Dolby trademark note.
    Also tools/spdif_gen.py: S/PDIF from the Analog Discovery 3's pattern generator
    (one 192-frame block at 48.8 kHz, looped), so the board can be tested on the
    bench without the TV. Its self-test reads the pin back and decodes it.
2026-11-12 README as a showcase, board renders, and the enclosure design
    - README: a short front page with the renders, what the board does, the
    measured results and the faults found. The reference material it used to
    hold is now in docs/ (board.md, firmware.md, bench.md).
    - hardware/renders: the board rendered in Blender from the KiCad file, bare
    copper on top and green mask underneath as built, with the receiver module
    stacked on top. render.sh regenerates them. The DAC and receiver modules
    are stand-in models.
    - enclosure: a printed base with a laser-cut 4 mm clear acrylic lid on M3
    heat-set inserts, as a parametric FreeCAD model with STEP, STL and the lid
    as DXF/SVG. Collision-checked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
    [Base.step, Base.stl, Lid_Plate.step, Lid_Plate_4mm_acrylic.dxf, User_Button.step, User_Button.stl, board.step, pcm5102_jack.step]
2026-11-13 Enclosure: measured heights, acrylic lid, four RCA outputs, pot cradle
    - The base now uses caliper measurements of the built board (standoffs, part
    heights, receiver module position) and the seller's drawing of the DIR9001.
    - Lid: a flat 4 mm clear acrylic plate for a CO2 laser (DXF and SVG in
    enclosure/lasercut), on M3 heat-set inserts in the base.
    - Rear panel: coax, toggle and optical above; four RCA jacks (7.3 mm holes,
    measured thread) and an 8 mm DC jack hole below.
    - The volume pot has no threaded bushing, so it sits in a printed cradle.
    Pot_Fit_Test.stl checks that fit before the whole base is printed.
    - enclosure/MEASUREMENTS.md lists what is measured and what is still assum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
    [Base.step, Base.stl, Knob.step, Knob.stl, Lid_Plate.step, Pot_Cradle.step, Pot_Cradle.stl, Pot_Fit_Test.stl]
2026-11-13 Enclosure: note the panel-mount TRS jacks for a later revision
2026-11-13 Stencil test coupon for the xTool F1 Ultra: ESP32-WROOM-32 paste apertures and cutting calibration features
    [stencil_test.dxf]
2026-11-13 Stencil test coupon: 22 mm square, openings only, no labels
    The ESP32-WROOM-32 pads with the test holes, combs and slots placed inside the
    footprint.
    [stencil_test.dxf]
2026-11-14 Lid cut files: full AutoCAD 2018 DXF, R2000 fallback, Illustrator-friendly SVG
    The old DXF was a minimal hand-written file with no $ACADVER, no handles,
    no BLOCKS or OBJECTS section and a layer table that referenced an
    undefined CONTINUOUS linetype, which Illustrator would not open.
    lasercut.py now writes the lid with ezdxf: AC1032 as the main file and an
    AC1015 copy, millimetres, real drawing extents in the header, closed
    LWPOLYLINEs with bulge arcs for the outline and vent slots, CIRCLEs for
    holes and LWPOLYLINE strokes for the engraving. The SVG has mm size and
    viewBox, one group per layer, 0.0254 mm hairlines and inline attributes.
    Geometry is unchanged: all 199 lines, arcs and circles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
    [Lid_Plate_4mm_acrylic.dxf, Lid_Plate_4mm_acrylic_R2000.dxf]
2026-11-14 Test the finished box: rear matrix and output levels with the AD3
    The assembled box on 9 V, fed S/PDIF from the AD3 (tools/spdif_gen.py) into the
    coax input, with the AD3's scope on the RCA outputs. Two graphs in the README:
    the rear matrix (antiphase at full level, in-phase cancelled by more than 47 dB,
    left only at half) and the four output levels against the bench values.
    Data in hardware/bench/box-test-2026-11-14.json, graphs from tools/plot_box_test.py.
    Also notes the brown-outs on a 12 V adapter in the closed box.
    [plot_box_test.py]
